IstratieStefan/ARC-Hardware/Render.png

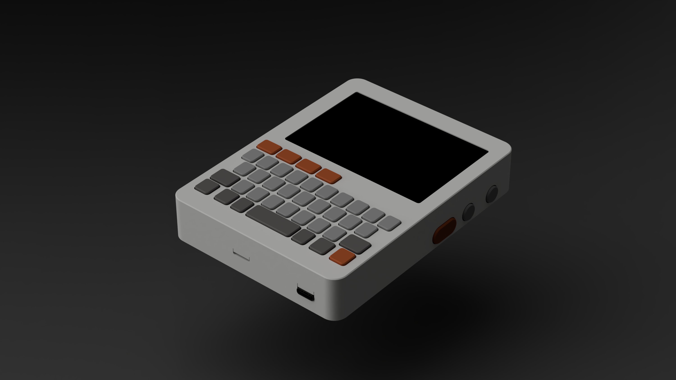
Render.png
