IstratieStefan/ARC-Hardware/Other/BOM.pdf

Nr Crt. | Reference | Value
1 C1,C4,C13,C14,C24,C25 2.2uF
| 2 C2,C11,C19 | 10uF
3 C3,C12,C15,C16,C17,C20,C21 0.1uF
| 4 C5 | 220uF
| 5 C9,C10 | 2.2nF
| 6 C18 | 1uF
| 7 C22,C23 | 220pF
8 D1,D2,D3,D4,D5,D6,D7,D8,D9,D10,D11,D12,D13,D14,D15,D16,D17,D18,D19,D20,D21,D22,D23,D24,D25,D26,D27,D28,D29,D30,D31,D32,D33,D34,D35,D36,D37,D38,D39 1N4148W
| 9 D40 | PMEG4020ER, 115
| 10 D41,D42,D43 | LED
| 11 FB1,FB2 | FerriteBead_Small
| 12 H2,H3,H4 | MountingHole
| 13 IC1 | TPS61032PWP
| 14 J1 | AudioJack3_Ground_SwitchTR
| 15 J2 | Conn_01x02_Pin
| 16 J4,J5 | Conn_01x08_Socket
| 17 JP1 | SolderJumper_2_Open
| 18 L1 | 6.8uH
| 19 LS1 | Speaker
| 20 P1 | USB_C_Plug_USB2.0
| 21 Q1 | BC857
| 22 Q2,Q3 | BSS84
| 23 R1 | 2K
| 24 R2,R16 | 4.5k
25 R3 | 100
26 R4,R11,R12,R13,R18 | 470
| 27 R5,R19 | 1K
| 28 R6 | 200K
| 29 R7 | 2.1M
| 30 R8 | 390K
| 31 R9 | 1.69M
| 32 R10 | 180K
| 33 R14,R15,R20 | 10K
| 34 RPi screen1 | ~
35 SW1,SW2,SW3,SW4,SW5,SW6,SW7,SW8,SW9,SW10,SW11,SW12,SW13,SW14,SW15,SW16,SW17,SW18,SW19,SW20,SW21,SW22,SW23,SW24,SW25,SW26,SW27,SW28,SW29,SW30,SW31,SW32,SW33,SW34,SW35,SW38,SW40,SW41,SW42 SW_Push
| 36 SW37,SW39,SW43 | SW_Push
| 37 SW44 | SW_SPDT
| 38 U1 | PCM5102A

39 U2 | Raspberry pi Zero 2 w
40 U3 | RP2040-ZERO
41 U4 | PAM8302AAD
42 U8 | MCP73833-xxx-MF

Footprint
Capacitor_SMD:C_0603_1608Metric_Pad1.08x0.95mm_HandSolder Capacitor_SMD:C_0805_2012Metric_Pad1.18x1.45mm_HandSolder Capacitor_SMD:C_0603_1608Metric_Pad1.08x0.95mm_HandSolder Capacitor_SMD:C_1210_3225Metric_Pad1.33x2.70mm_HandSolder Capacitor_SMD:C_0603_1608Metric_Pad1.08x0.95mm_HandSolder Capacitor_SMD:C_0603_1608Metric_Pad1.08x0.95mm_HandSolder Capacitor_SMD:C_0603_1608Metric_Pad1.08x0.95mm_HandSolder Diode_SMD:D_0603_1608Metric_Pad1.05x0.95mm_HandSolder Diode_SMD:Nexperia_CFP3_SOD-123W LED_SMD:LED_0805_2012Metric_Pad1.15x1.40mm_HandSolder Inductor_SMD:L_0603_1608Metric_Pad1.05x0.95mm_HandSolder MountingHole:MountingHole_2.2mm_M2_Pad Package_SO:HTSSOP-16-1EP_4.4x5mm_P0.65mm_EP3.4x5mm_Mask2.66x2.46mm Connector_Audio:Jack_3.5mm_CUI_SJ2-3593D-SMT_Horizontal Connector_JST:JST_PH_S2B-PH-K_1x02_P2.00mm_Horizontal Connector_PinSocket_2.54mm:PinSocket_1x08_P2.54mm_Vertical Jumper:SolderJumper-2_P1.3mm_Open_Pad1.0x1.5mm Inductor_SMD:L_Bourns_SRP5030T Connector_JST:JST_PH_S2B-PH-K_1x02_P2.00mm_Horizontal Connector_USB:USB_C_Receptacle_GCT_USB4125-xx-x_6P_TopMnt_Horizontal Package_TO_SOT_SMD:SOT-23
Package_TO_SOT_SMD:SOT-23
Resistor_SMD:R_0603_1608Metric_Pad0.98x0.95mm_HandSolder Resistor_SMD:R_0603_1608Metric_Pad0.98x0.95mm_HandSolder Resistor_SMD:R_0603_1608Metric_Pad0.98x0.95mm_HandSolder Resistor_SMD:R_0603_1608Metric_Pad0.98x0.95mm_HandSolder Resistor_SMD:R_0603_1608Metric_Pad0.98x0.95mm_HandSolder Resistor_SMD:R_0603_1608Metric_Pad0.98x0.95mm_HandSolder Resistor_SMD:R_0603_1608Metric_Pad0.98x0.95mm_HandSolder Resistor_SMD:R_0603_1608Metric_Pad0.98x0.95mm_HandSolder Resistor_SMD:R_0603_1608Metric_Pad0.98x0.95mm_HandSolder Resistor_SMD:R_0603_1608Metric_Pad0.98x0.95mm_HandSolder Resistor_SMD:R_0603_1608Metric_Pad0.98x0.95mm_HandSolder arc:3.5inch Display
Button_Switch_SMD:SW_SPST_TL3342 Button_Switch_THT:SW_Tactile_SPST_Angled_PTS645Vx31-2LFS Button_Switch_SMD:SW_SPDT_PCM12 Package_SO:TSSOP-20_4.4x6.5mm_P0.65mm

Module:Raspberry_Pi_Zero_Socketed_THT_FaceDown_MountingHoles RP2040-Tiny_kicad-main:RP2040-Tiny-smd Package_SO:MSOP-8_3x3mm_P0.65mm Package_DFN_QFN:DFN-10-1EP_3x3mm_P0.5mm_EP1.58x2.35mm

Datasheet Qty | DNP | Link Exclude from BOM Unit Price
~ | 6 | 0.2734
~ | 3 | 0.5152
~ | 7 | 0.3
~ | 1 | 5.7
~ | 2 | 0.36
~ | 1 | 0.55
~ | 2 | 1.9
https://www.vishay.com/docs/85748/1n4148w.pdf 39 | 0.1975
https://assets.nexperia.com/documents/data-sheet/PMEG4020ER.pdf 1 | 1.9
~ | 3 | 0.35
~ | 2 | 0.42
~ | 3 | Excluded from BOM
http://www.ti.com/lit/ds/symlink/tps61030.pdf 1 | 15.64
~ | 1 | 5.23
~ | 1
~ | 2
~ | 1 | Excluded from BOM
~ | 1 | 3.44
~ | 1 | 6.75
https://www.usb.org/sites/default/files/documents/usb_type-c.zip 1 | 2.67
https://www.onsemi.com/pub/Collateral/BC860-D.pdf 1 | 1.47
http://assets.nexperia.com/documents/data-sheet/BSS84.pdf 2 | 2.22
~ | 1 | 0.3
~ | 2 | 0.55
~ | 1 | 0.24
~ | 5 | 0.55
~ | 2 | 0.24
~ | 1 | 0.55
~ | 1 | 0.45
~ | 1 | 0.55
~ | 1 | 0.45
~ | 1 | 0.55
~ | 3 | 0.12
| 1
~ | 39
~ | 3 | 1.49
~ | 1 | 5.02
https://www.ti.com/lit/ds/symlink/pcm5102a.pdf 1 | 20.07

1
1
https://www.diodes.com/assets/Datasheets/PAM8302A.pdf 1 | 2.26
https://ww1.microchip.com/downloads/aemDocuments/documents/OTH/ProductDocuments/DataSheets/22005b.pdf 1 | 6.34
TOTAL | 113.1285

Total Price
1.6404
1.5456
2.1
5.7
0.72
0.55
3.8
7.7025
1.9
1.05
0.84
0
15.64
5.23
0
0
0
3.44
6.75
2.67
1.47
4.44
0.3
1.1
0.24
2.75
0.48
0.55
0.45
0.55
0.45
0.55
0.36
0
0
4.47
5.02
20.07

0
0
2.26
6.34

Links
https://www.tme.eu/ro/details/cc0603krx5r6bb225/condensatoare-mlcc-smd/yageo/https://www.tme.eu/ro/details/cl21a106kaynnne/condensatoare-mlcc-smd/samsung/https://www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

https://ro.mouser.com/ProductDetail/Texas-Instruments/TPS61032PWPR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

https://www.tme.eu/ro/details/zl262-8sg/pini-cu-benzi-si-soclu/connfly/ds1023-1-8s21/

https://ro.mouser.com/ProductDetail/Bourns/SRP5030T-6R8M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

https://ro.mouser.com/ProductDetail/CK/PTS645VH83-2-LFS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

De luat
