IstratieStefan/ARC-Hardware/STL/Power Button.stl

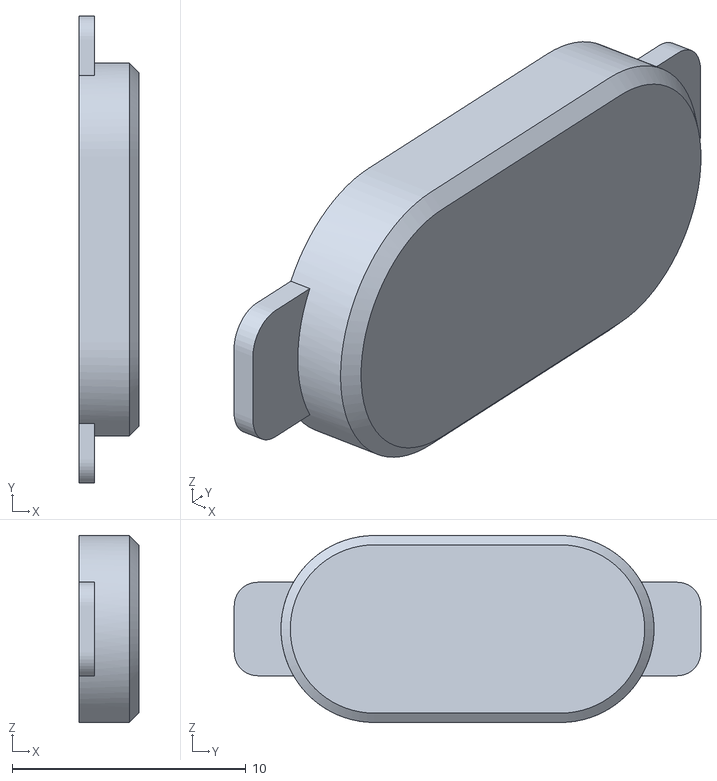
[picture p2: CAD file, 2025-07-25]
STL/Power Button.stl
2.55 x 20.0 x 8.00
