IstratieStefan/ARC-Hardware/STL/Back Case.stl

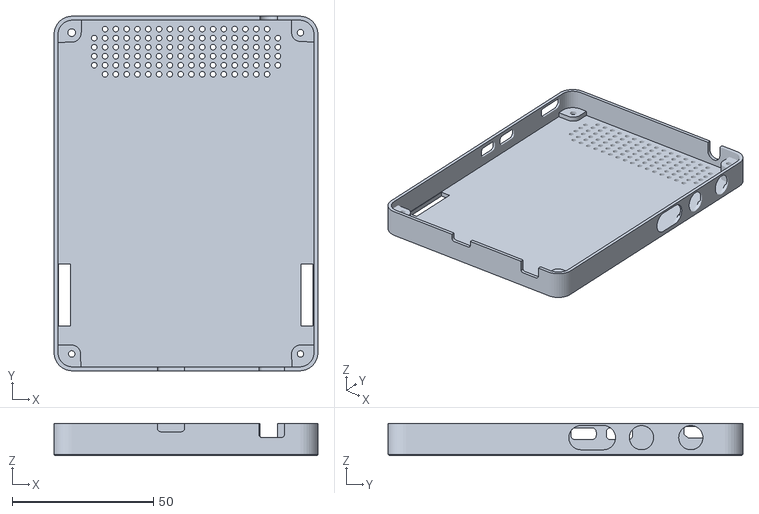
[picture p3: CAD file, 2025-07-25]
STL/Back Case.stl
93.5 x 125.6 x 11.5
