IstratieStefan/ARC-Hardware/STL/Ctrl Key.stl

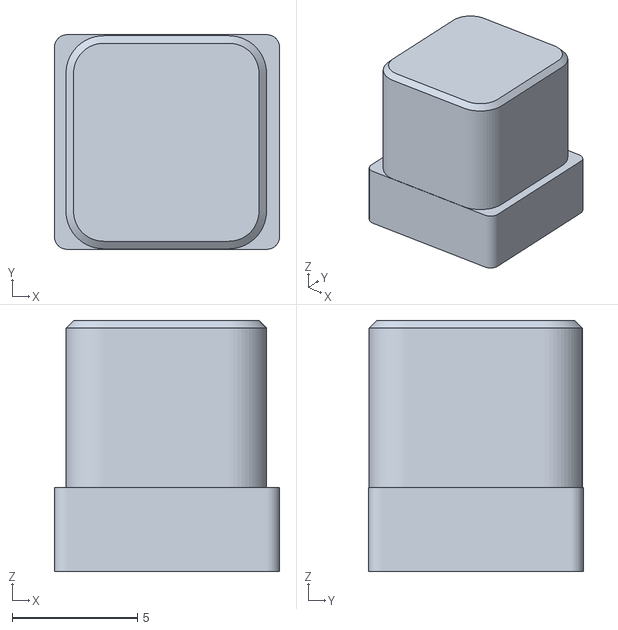
[picture p4: CAD file, 2025-07-25]
STL/Ctrl Key.stl
8.98 x 8.57 x 10.0
