IstratieStefan/ARC-Hardware/STL/Menu Key.stl

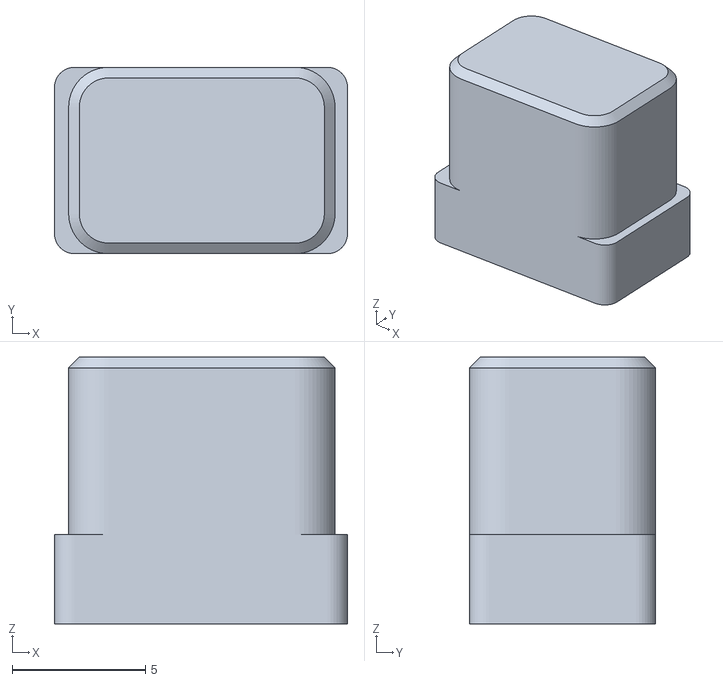
[picture p5: CAD file, 2025-07-25]
STL/Menu Key.stl
11.0 x 7.00 x 10.0
