IstratieStefan/ARC-Hardware/STL/Shift Key.stl

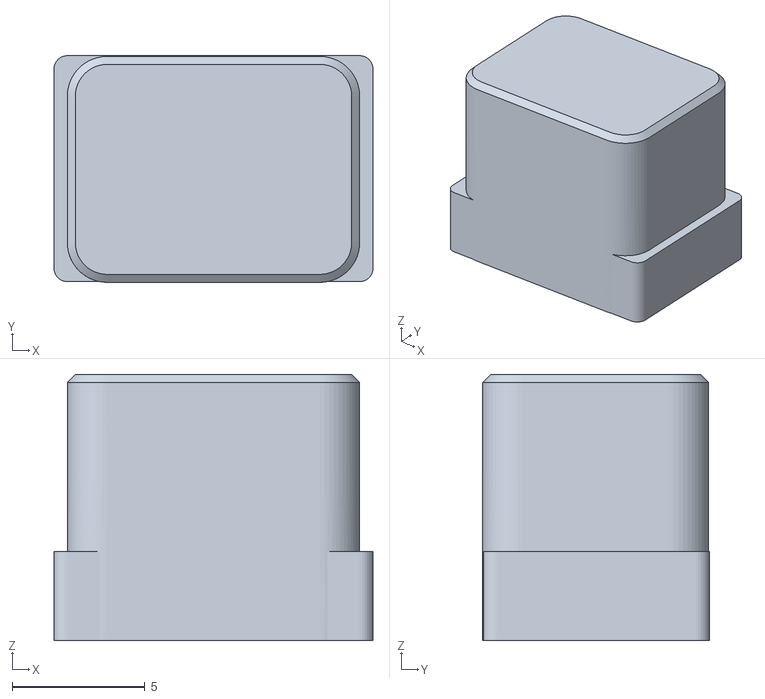
[picture p6: CAD file, 2025-07-25]
STL/Shift Key.stl
12.0 x 8.53 x 10.0
