IstratieStefan/ARC-Hardware/STL/Volume Key.stl

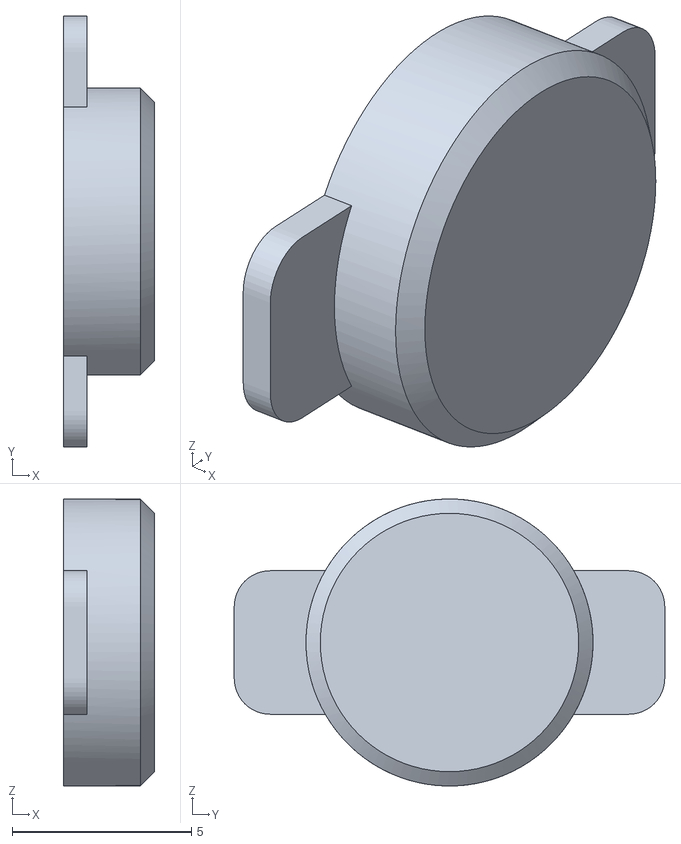
[picture p7: CAD file, 2025-07-25]
STL/Volume Key.stl
2.55 x 12.0 x 8.00
