IstratieStefan/ARC-Hardware/STL/Front Case.stl

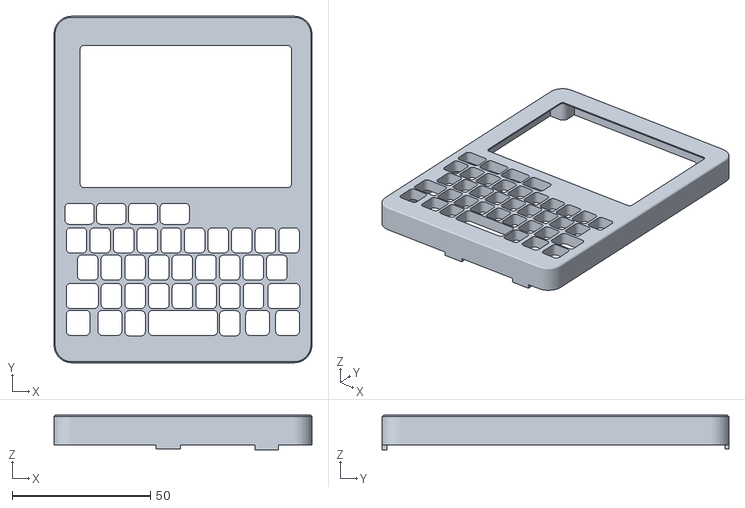
[picture p8: CAD file, 2025-07-25]
STL/Front Case.stl
93.5 x 125.6 x 12.5
