IstratieStefan/ARC-Hardware/STL/Normal Key.stl

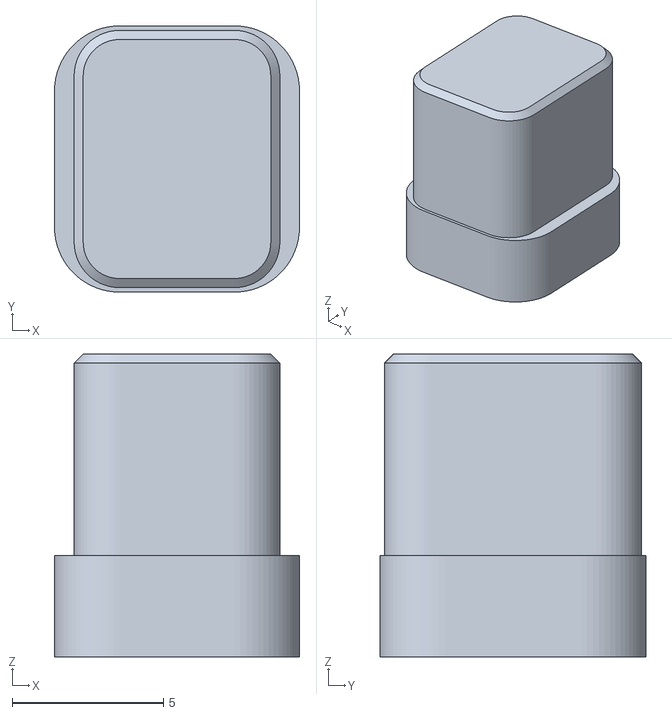
[picture p9: CAD file, 2025-07-25]
STL/Normal Key.stl
8.10 x 8.80 x 10.0
