IstratieStefan/ARC-Hardware/STL/Space Key.stl

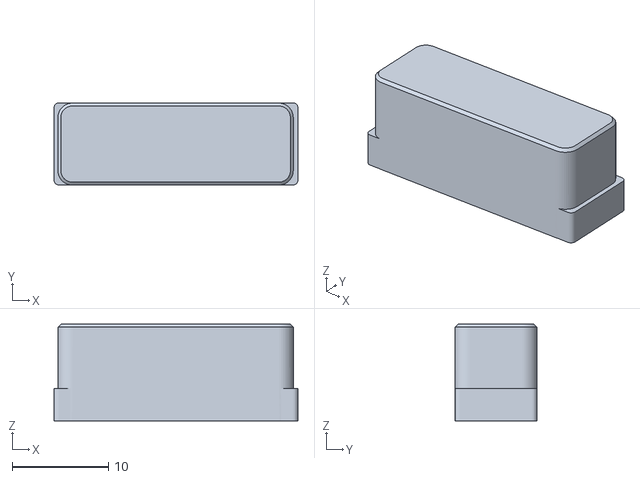
[picture p10: CAD file, 2025-07-25]
STL/Space Key.stl
25.3 x 8.52 x 10.0
