IstratieStefan/ARC-Hardware/KICAD PROJECT/KICAD PROJECT.pdf

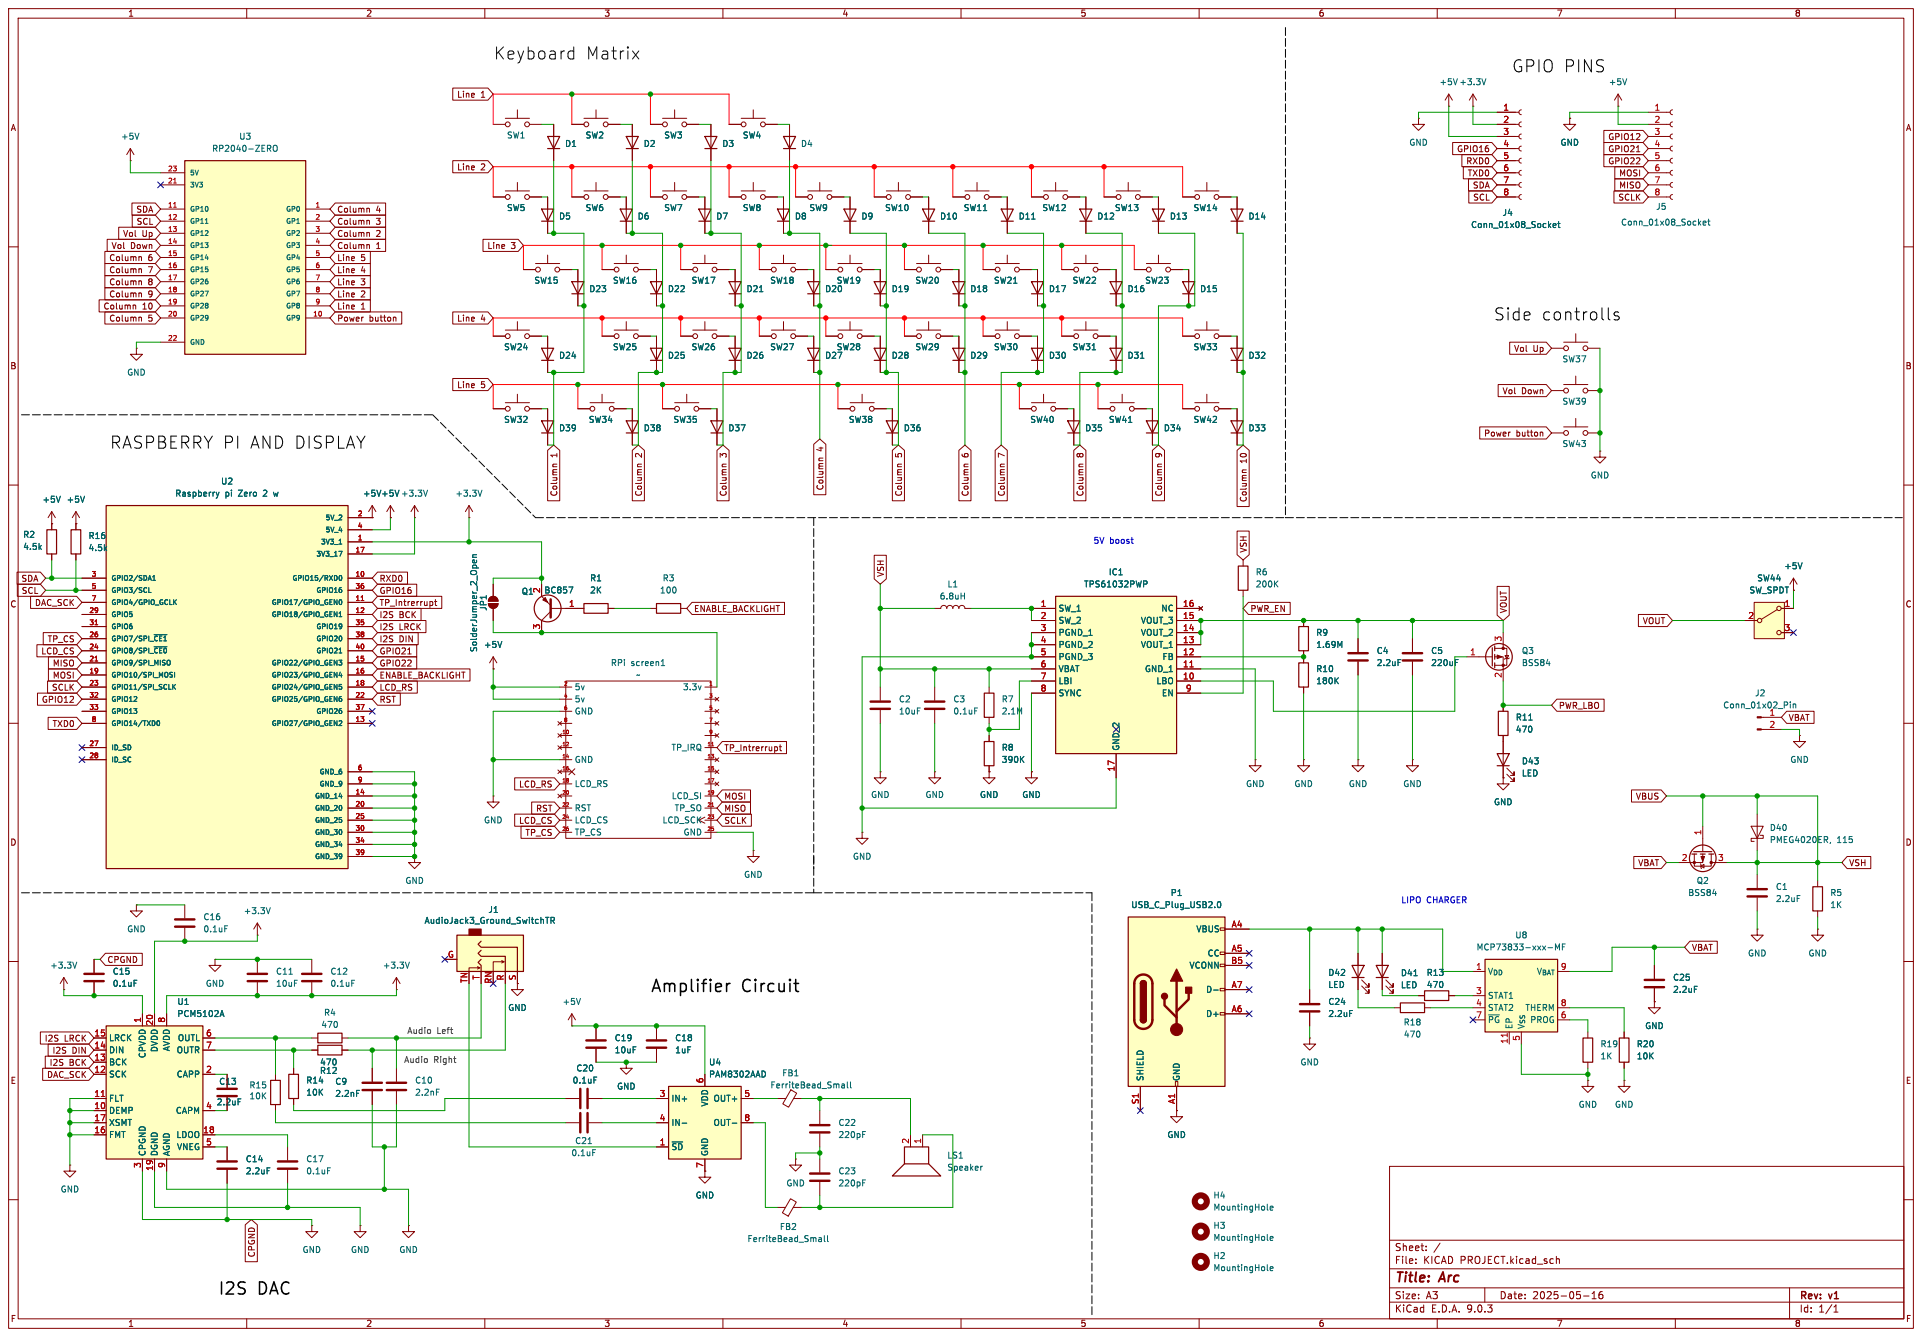
[picture p11: page 1]

5V boost RASPBERRY PI AND DISPLAY

9 OUTL 6 OUTR 7 CAPP 2 CAPM 4

Audio Left Audio Right
