IstratieStefan/ARC-Hardware/KICAD PROJECT/KICAD PROJECT.kicad_pcb

## KiCad design KICAD PROJECT/KICAD PROJECT.kicad_pcb (2025-07-25)

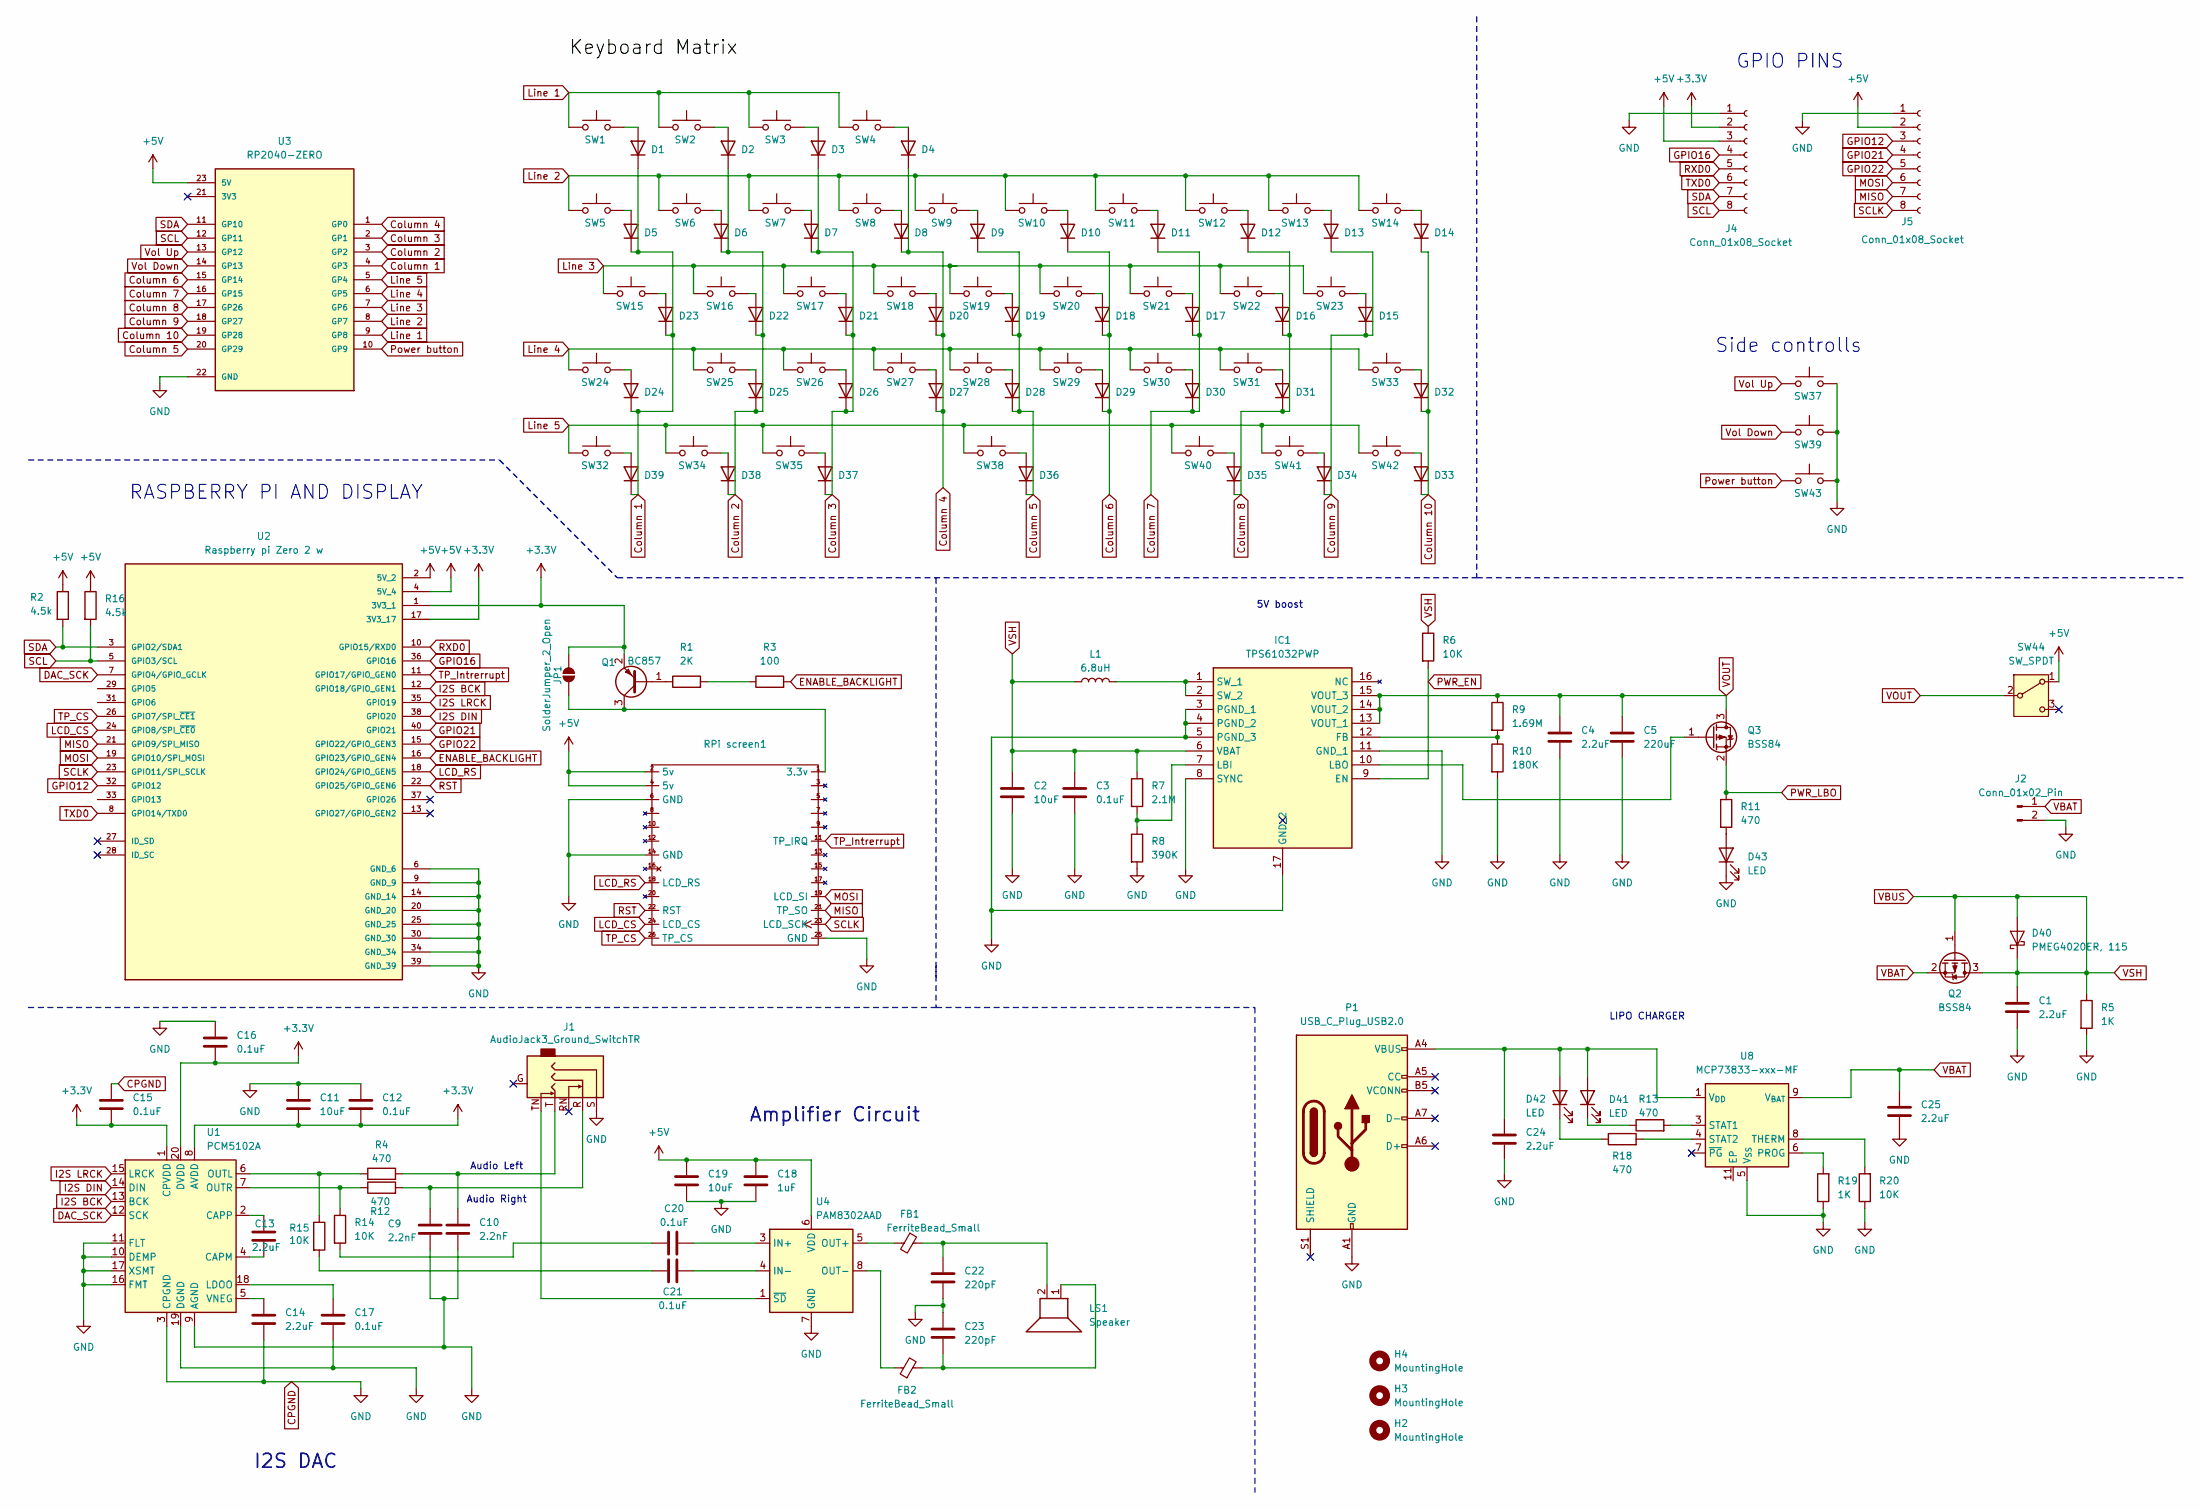
[picture p12: schematic KICAD PROJECT.kicad_sch, Arc]

Parts:
C1, C4, C13, C14, C24, C25: 2.2uF; C_0603_1608Metric_Pad1.08x0.95mm_HandSolder
C2, C11, C19: 10uF; C_0805_2012Metric_Pad1.18x1.45mm_HandSolder
C3, C12, C15, C16, C17, C20, C21: 0.1uF; C_0603_1608Metric_Pad1.08x0.95mm_HandSolder
C5: 220uF; C_1210_3225Metric_Pad1.33x2.70mm_HandSolder
C9, C10: 2.2nF; C_0603_1608Metric_Pad1.08x0.95mm_HandSolder
C18: 1uF; C_0603_1608Metric_Pad1.08x0.95mm_HandSolder
C22, C23: 220pF; C_0603_1608Metric_Pad1.08x0.95mm_HandSolder
D1, D2, D3, D4, D5, D6, D7, D8, D9, D10, D11, D12, D13, D14, D15, D16, D17, D18, D19, D20, D21, D22, D23, D24, D25, D26, D27, D28, D29, D30, D31, D32, D33, D34, D35, D36, D37, D38, D39: 1N4148W; D_0603_1608Metric_Pad1.05x0.95mm_HandSolder
D40: PMEG4020ER, 115; Nexperia_CFP3_SOD-123W
D41, D42, D43: LED; LED_0805_2012Metric_Pad1.15x1.40mm_HandSolder
FB1, FB2: FerriteBead_Small; L_0603_1608Metric_Pad1.05x0.95mm_HandSolder
H2, H3, H4: MountingHole; MountingHole_2.2mm_M2_Pad
IC1: TPS61032PWP; HTSSOP-16-1EP_4.4x5mm_P0.65mm_EP3.4x5mm_Mask2.66x2.46mm; Mouser Part Number 595-TPS61032PWP
J1: AudioJack3_Ground_SwitchTR; Jack_3.5mm_CUI_SJ2-3593D-SMT_Horizontal
J2: Conn_01x02_Pin; JST_PH_S2B-PH-K_1x02_P2.00mm_Horizontal
J4, J5: Conn_01x08_Socket; PinSocket_1x08_P2.54mm_Vertical
JP1: SolderJumper_2_Open; SolderJumper-2_P1.3mm_Open_Pad1.0x1.5mm
L1: 6.8uH; L_Bourns_SRP5030T
LS1: Speaker; JST_PH_S2B-PH-K_1x02_P2.00mm_Horizontal
P1: USB_C_Plug_USB2.0; USB_C_Receptacle_GCT_USB4125-xx-x_6P_TopMnt_Horizontal
Q1: BC857; SOT-23
Q2, Q3: BSS84; SOT-23
R1: 2K; R_0603_1608Metric_Pad0.98x0.95mm_HandSolder
R2, R16: 4.5k; R_0603_1608Metric_Pad0.98x0.95mm_HandSolder
R3: 100; R_0603_1608Metric_Pad0.98x0.95mm_HandSolder
R4, R11, R12, R13, R18: 470; R_0603_1608Metric_Pad0.98x0.95mm_HandSolder
R5, R19: 1K; R_0603_1608Metric_Pad0.98x0.95mm_HandSolder
R6, R14, R15, R20: 10K; R_0603_1608Metric_Pad0.98x0.95mm_HandSolder
R7: 2.1M; R_0603_1608Metric_Pad0.98x0.95mm_HandSolder
R8: 390K; R_0603_1608Metric_Pad0.98x0.95mm_HandSolder
R9: 1.69M; R_0603_1608Metric_Pad0.98x0.95mm_HandSolder
R10: 180K; R_0603_1608Metric_Pad0.98x0.95mm_HandSolder
RPi screen1: 3.5inch Display
SW1, SW2, SW3, SW4, SW5, SW6, SW7, SW8, SW9, SW10, SW11, SW12, SW13, SW14, SW15, SW16, SW17, SW18, SW19, SW20, SW21, SW22, SW23, SW24, SW25, SW26, SW27, SW28, SW29, SW30, SW31, SW32, SW33, SW34, SW35, SW38, SW40, SW41, SW42: SW_Push; SW_SPST_TL3342
SW37, SW39, SW43: SW_Push; SW_Tactile_SPST_Angled_PTS645Vx31-2LFS
SW44: SW_SPDT; SW_SPDT_PCM12
U1: PCM5102A; TSSOP-20_4.4x6.5mm_P0.65mm
U2: Raspberry pi Zero 2 w; Raspberry_Pi_Zero_Socketed_THT_FaceDown_MountingHoles; PARTREV April 2024
U3: RP2040-ZERO; RP2040-Tiny-smd; PARTREV NA
U4: PAM8302AAD; MSOP-8_3x3mm_P0.65mm
U8: MCP73833-xxx-MF; DFN-10-1EP_3x3mm_P0.5mm_EP1.58x2.35mm

Connections:
+3.3V: C11.2, C12.2, C15.2, C16.2, J4.2, JP1.2 (B), Q1.2 (E), U1.1 (CPVDD), U1.8 (AVDD), U1.20 (DVDD), U2.1 (3V3_1), U2.17 (3V3_17)
+5V: C18.1, C19.1, J4.3, J5.2, R2.1, R16.1, RPi screen1.2 (5v), RPi screen1.4 (5v), SW44.1 (A), U2.2 (5V_2), U2.4 (5V_4), U3.23 (5V), U4.6 (VDD)
CPGND: C1.2, C2.2, C3.2, C4.2, C5.2, C9.2, C10.2, C11.1, C12.1, C14.2, C15.1, C16.1, C17.2, C18.2, C19.2, C22.2, C23.1, C24.2, C25.2, D43.1 (K), IC1.3 (PGND_1), IC1.4 (PGND_2), IC1.5 (PGND_3), IC1.8 (SYNC), IC1.11 (GND_1), IC1.17 (GND_2), J1.S, J2.2, J4.1, J5.1, P1.A1 (GND), P1.A12 (GND), P1.B1 (GND), P1.B12 (GND), R5.2, R8.2, R10.2, R19.1, R20.1, RPi screen1.6 (GND), RPi screen1.14 (GND), RPi screen1.25 (GND), SW37.2, SW39.2, SW43.2, U1.3 (CPGND), U1.9 (AGND), U1.10 (DEMP), U1.11 (FLT), U1.16 (FMT), U1.17 (XSMT), U1.19 (DGND), U2.6 (GND_6), U2.9 (GND_9), U2.14 (GND_14), U2.20 (GND_20), U2.25 (GND_25), U2.30 (GND_30), U2.34 (GND_34), U2.39 (GND_39), U3.22 (GND), U4.7 (GND), U8.5 (V_{SS})
Column 1: D1.1 (K), D5.1 (K), D23.1 (K), D24.1 (K), D39.1 (K), U3.4 (GP3)
Column 2: D2.1 (K), D6.1 (K), D22.1 (K), D25.1 (K), D38.1 (K), U3.3 (GP2)
Column 3: D3.1 (K), D7.1 (K), D21.1 (K), D26.1 (K), D37.1 (K), U3.2 (GP1)
Column 4: D4.1 (K), D8.1 (K), D20.1 (K), D27.1 (K), U3.1 (GP0)
Column 5: D9.1 (K), D19.1 (K), D28.1 (K), D36.1 (K), U3.20 (GP29)
Column 6: D10.1 (K), D18.1 (K), D29.1 (K), U3.15 (GP14)
Column 7: D11.1 (K), D17.1 (K), D30.1 (K), U3.16 (GP15)
Column 8: D12.1 (K), D16.1 (K), D31.1 (K), D35.1 (K), U3.17 (GP26)
Column 9: D13.1 (K), D15.1 (K), D34.1 (K), U3.18 (GP27)
Column 10: D14.1 (K), D32.1 (K), D33.1 (K), U3.19 (GP28)
DAC_SCK: U1.12 (SCK), U2.7 (GPIO4/GPIO_GCLK)
ENABLE_BACKLIGHT: R3.2, U2.16 (GPIO23/GPIO_GEN4)
GPIO12: J5.3, U2.32 (GPIO12)
GPIO16: J4.4, U2.36 (GPIO16)
GPIO21: J5.4, U2.40 (GPIO21)
GPIO22: J5.5, U2.15 (GPIO22/GPIO_GEN3)
I2S BCK: U1.13 (BCK), U2.12 (GPIO18/GPIO_GEN1)
I2S DIN: U1.14 (DIN), U2.38 (GPIO20)
I2S LRCK: U1.15 (LRCK), U2.35 (GPIO19)
LCD_CS: RPi screen1.24 (LCD_CS), U2.24 (GPIO8/SPI_~CE0)
LCD_RS: RPi screen1.18 (LCD_RS), U2.18 (GPIO24/GPIO_GEN5)
Line 1: SW1.1, SW2.1, SW3.1, SW4.1, U3.9 (GP8)
Line 2: SW5.1, SW6.1, SW7.1, SW8.1, SW9.1, SW10.1, SW11.1, SW12.1, SW13.1, SW14.1, U3.8 (GP7)
Line 3: SW15.1, SW16.1, SW17.1, SW18.1, SW19.1, SW20.1, SW21.1, SW22.1, SW23.1, U3.7 (GP6)
Line 4: SW24.1, SW25.1, SW26.1, SW27.1, SW28.1, SW29.1, SW30.1, SW31.1, SW33.1, U3.6 (GP5)
Line 5: SW32.1, SW34.1, SW35.1, SW38.1, SW40.1, SW41.1, SW42.1, U3.5 (GP4)
MISO: J5.7, RPi screen1.21 (TP_SO), U2.21 (GPIO9/SPI_MISO)
MOSI: J5.6, RPi screen1.19 (LCD_SI), U2.19 (GPIO10/SPI_MOSI)
unnamed: C9.1, J1.R, R12.2
unnamed: C10.1, J1.T, R4.2
unnamed: C20.1, R14.2
unnamed: C21.2, R15.2
unnamed: C22.1, FB1.1, LS1.2
unnamed: C23.2, FB2.2, LS1.1
unnamed: D1.2 (A), SW1.2
unnamed: D2.2 (A), SW2.2
unnamed: D3.2 (A), SW3.2
unnamed: D4.2 (A), SW4.2
unnamed: D5.2 (A), SW5.2
unnamed: D6.2 (A), SW6.2
unnamed: D7.2 (A), SW7.2
unnamed: D8.2 (A), SW8.2
unnamed: D9.2 (A), SW9.2
unnamed: D10.2 (A), SW10.2
unnamed: D11.2 (A), SW11.2
unnamed: D12.2 (A), SW12.2
unnamed: D13.2 (A), SW13.2
unnamed: D14.2 (A), SW14.2
unnamed: D15.2 (A), SW23.2
unnamed: D16.2 (A), SW22.2
unnamed: D17.2 (A), SW21.2
unnamed: D18.2 (A), SW20.2
unnamed: D19.2 (A), SW19.2
unnamed: D20.2 (A), SW18.2
unnamed: D21.2 (A), SW17.2
unnamed: D22.2 (A), SW16.2
unnamed: D23.2 (A), SW15.2
unnamed: D24.2 (A), SW24.2
unnamed: D25.2 (A), SW25.2
unnamed: D26.2 (A), SW26.2
unnamed: D27.2 (A), SW27.2
unnamed: D28.2 (A), SW28.2
unnamed: D29.2 (A), SW29.2
unnamed: D30.2 (A), SW30.2
unnamed: D31.2 (A), SW31.2
unnamed: D32.2 (A), SW33.2
unnamed: D33.2 (A), SW42.2
unnamed: D34.2 (A), SW41.2
unnamed: D35.2 (A), SW40.2
unnamed: D36.2 (A), SW38.2
unnamed: D37.2 (A), SW35.2
unnamed: D38.2 (A), SW34.2
unnamed: D39.2 (A), SW32.2
unnamed: C24.1, D41.2 (A), D42.2 (A), P1.A4 (VBUS), P1.A9 (VBUS), P1.B4 (VBUS), P1.B9 (VBUS), U8.1 (V_{DD}), U8.2 (V_{DD})
unnamed: D41.1 (K), R13.1
unnamed: D42.1 (K), R18.1
unnamed: D43.2 (A), R11.2
unnamed: IC1.12 (FB), R9.2, R10.1
unnamed: IC1.7 (LBI), R7.2, R8.1
unnamed: IC1.10 (LBO), Q3.1 (G)
unnamed: IC1.1 (SW_1), IC1.2 (SW_2), L1.2
unnamed: JP1.1 (A), Q1.3 (C), RPi screen1.1 (3.3v)
unnamed: Q1.1 (B), R1.1
unnamed: R1.2, R3.1
unnamed: C13.2, U1.4 (CAPM)
unnamed: C13.1, U1.2 (CAPP)
unnamed: C17.1, U1.18 (LDOO)
unnamed: R4.1, R15.1, U1.6 (OUTL)
unnamed: R12.1, R14.1, U1.7 (OUTR)
unnamed: C14.1, U1.5 (VNEG)
unnamed: C20.2, U4.3 (IN+)
unnamed: C21.1, U4.4 (IN-)
unnamed: FB1.2, U4.5 (OUT+)
unnamed: FB2.1, U4.8 (OUT-)
unnamed: J1.TN, U4.1 (~SD)
unnamed: R19.2, U8.6 (PROG)
unnamed: R13.2, U8.3 (STAT1)
unnamed: R18.2, U8.4 (STAT2)
unnamed: R20.2, U8.8 (THERM)
PWR_EN: IC1.9 (EN), R6.2
PWR_LBO: Q3.2 (S), R11.1
Power button: SW43.1, U3.10 (GP9)
RST: RPi screen1.22 (RST), U2.22 (GPIO25/GPIO_GEN6)
RXD0: J4.5, U2.10 (GPIO15/RXD0)
SCL: J4.8, R16.2, U2.5 (GPIO3/SCL), U3.12 (GP11)
SCLK: J5.8, RPi screen1.23 (LCD_SCK), U2.23 (GPIO11/SPI_SCLK)
SDA: J4.7, R2.2, U2.3 (GPIO2/SDA1), U3.11 (GP10)
TP_CS: RPi screen1.26 (TP_CS), U2.26 (GPIO7/SPI_~CE1)
TP_Intrerrupt: RPi screen1.11 (TP_IRQ), U2.11 (GPIO17/GPIO_GEN0)
TXD0: J4.6, U2.8 (GPIO14/TXD0)
VBAT: C25.1, J2.1, Q2.2 (S), U8.9 (V_{BAT}), U8.10 (V_{BAT})
VBUS: C1.1, C2.1, C3.1, D40.1 (K), D40.2 (A), IC1.6 (VBAT), L1.1, Q2.1 (G), Q2.3 (D), R5.1, R6.1, R7.1
VOUT: C4.1, C5.1, IC1.13 (VOUT_1), IC1.14 (VOUT_2), IC1.15 (VOUT_3), Q3.3 (D), R9.1, SW44.2 (B)
Vol Down: SW39.1, U3.14 (GP13)
Vol Up: SW37.1, U3.13 (GP12)

Notes on the sheet:
Amplifier Circuit
I2S DAC
Audio Right
GPIO PINS
RASPBERRY PI AND DISPLAY
Side controlls
Audio Left
5V boost
LIPO CHARGER

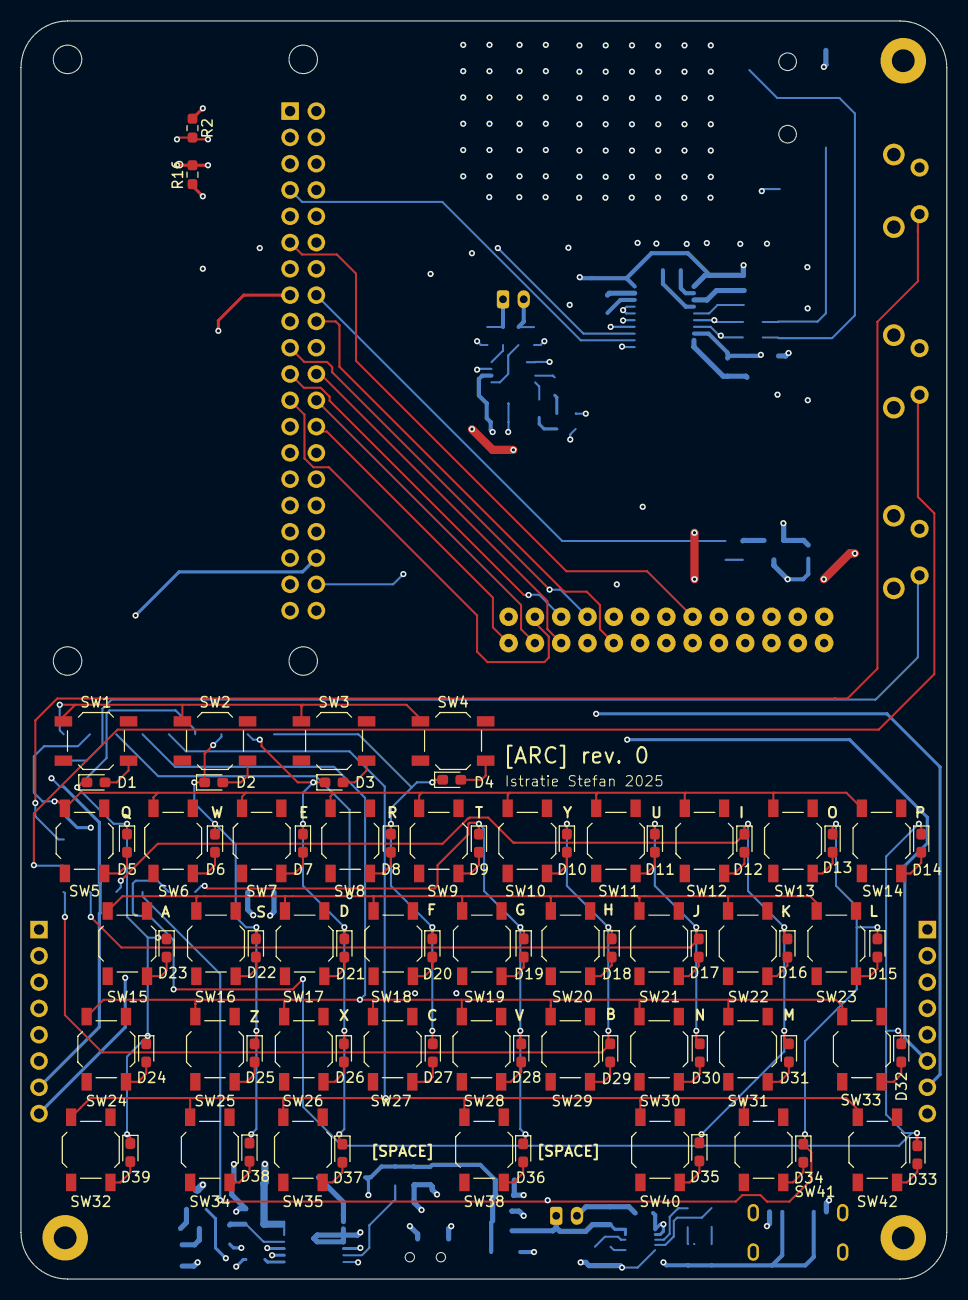
[picture p13: board KICAD PROJECT.kicad_pcb from above]

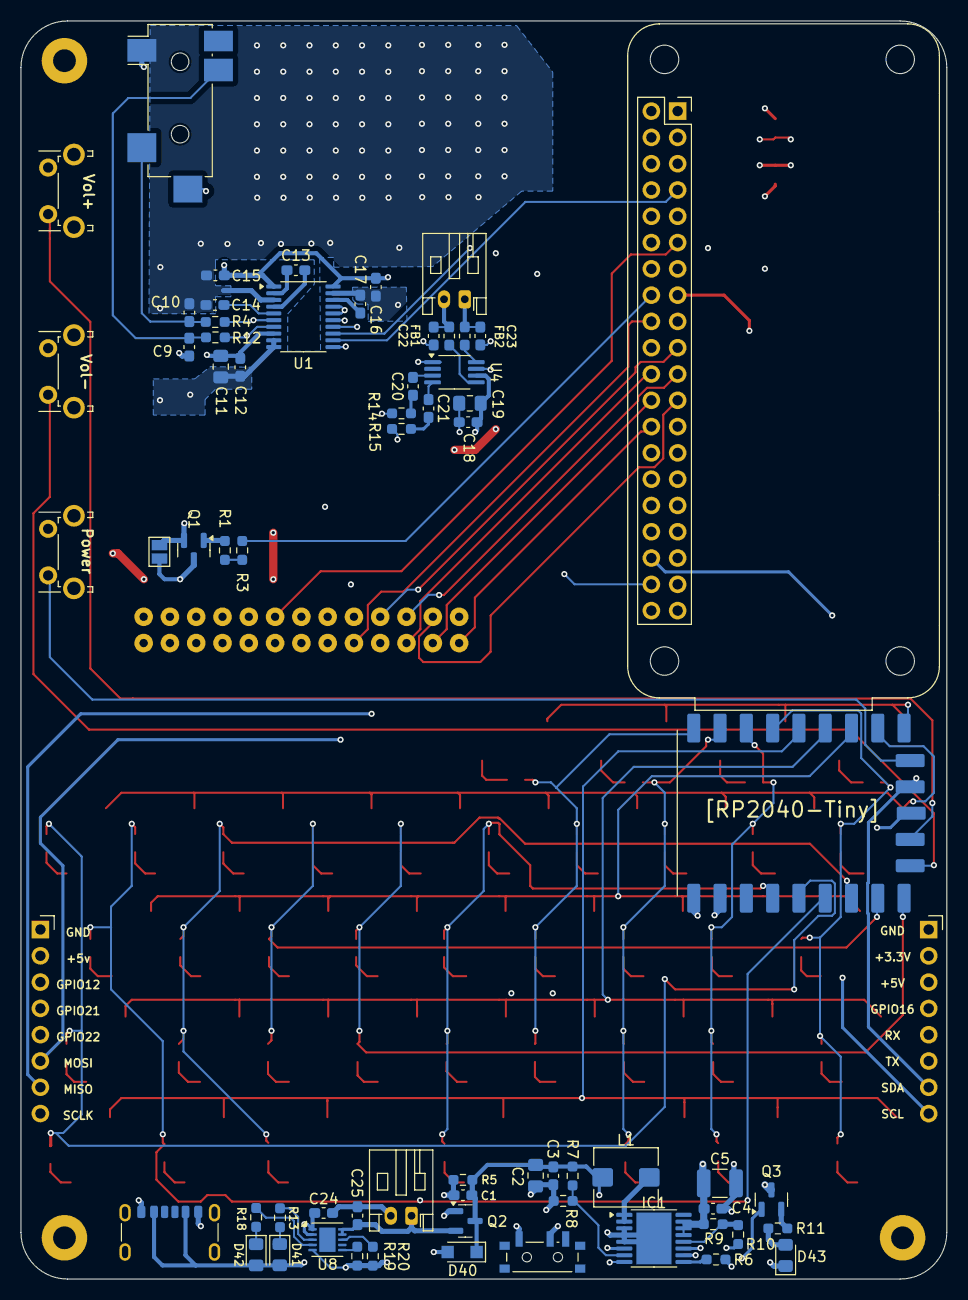
[picture p14: board KICAD PROJECT.kicad_pcb from below]

Board: 4 copper layers, 89.5 x 121.5 mm, 150 parts (66 on the bottom side), 118 nets.
