IstratieStefan/ARC-Hardware/(commit log)

2025-06-23 v2 pcb
2025-06-27 Kicad Project
    [KICAD PROJECT.kicad_pcb, KICAD PROJECT.kicad_sch]
2025-06-29 3d files updates
    far from final bro
    [BACK.stl, Blank key.stl, FRONT.stl, SIDE BUTTON.stl, key+0.1 tolerance.stl, key.stl]
2025-07-13 Updates and gerbers
    [KICAD PROJECT-B_Cu.gbr, KICAD PROJECT-B_Mask.gbr, KICAD PROJECT-B_Paste.gbr, KICAD PROJECT-B_Silkscreen.gbr, KICAD PROJECT-Edge_Cuts.gbr, KICAD PROJECT-F_Cu.gbr, KICAD PROJECT-F_Mask.gbr, KICAD PROJECT-F_Paste.gbr]
2025-07-25 Stl Files + Render +Organized Repo
    [BACK.stl, BOM.csv, BOM.xlsx, Back Case.stl, Blank key.stl, Ctrl Key.stl, FRONT.stl, Front Case.stl]
